camerong888/Capstone-PCB/Capstone PCB for gabe.png

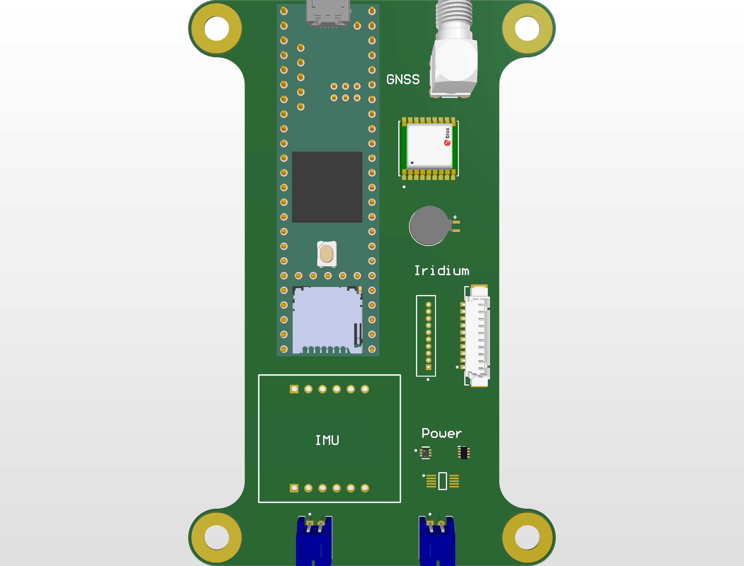
Capstone PCB for gabe.png
