camerong888/Capstone-PCB/Capstone PCB Top View.png

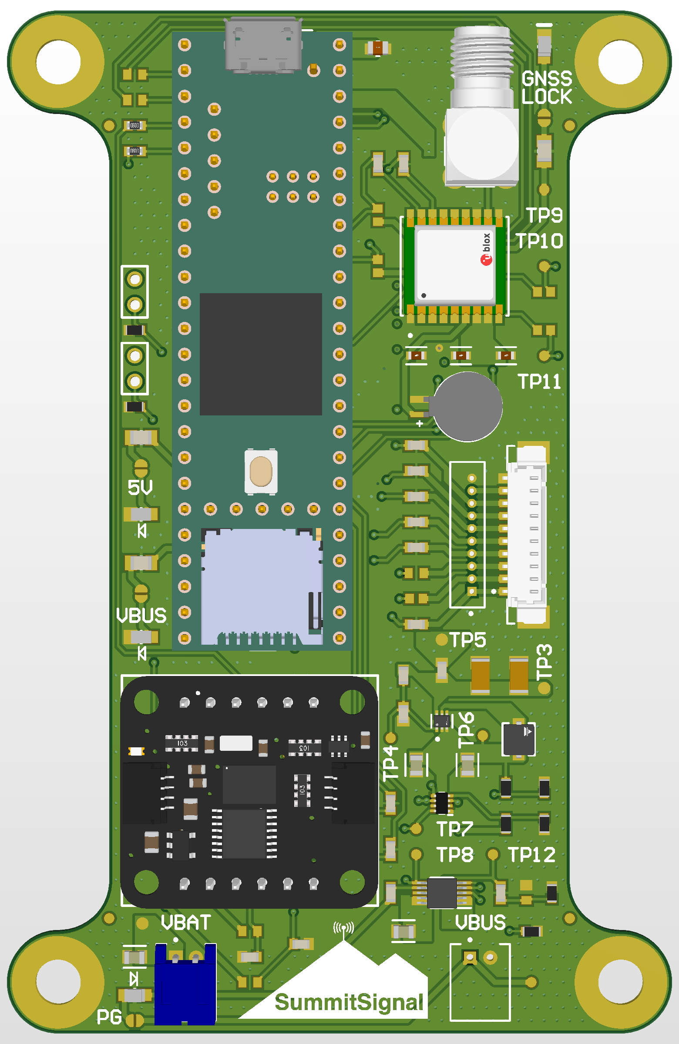
Capstone PCB Top View.png
