camerong888/Capstone-PCB/Capstone PCB back.png

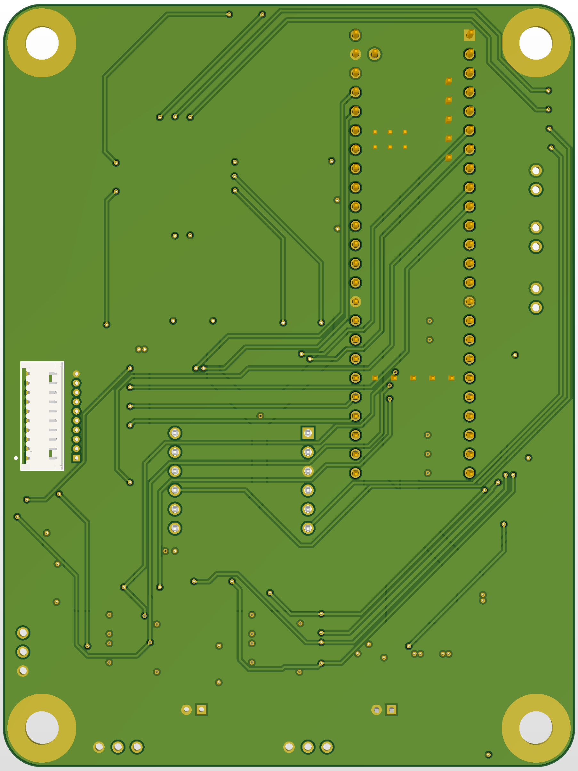
Capstone PCB back.png
