camerong888/Capstone-PCB/Capstone PCB Bottom View.png

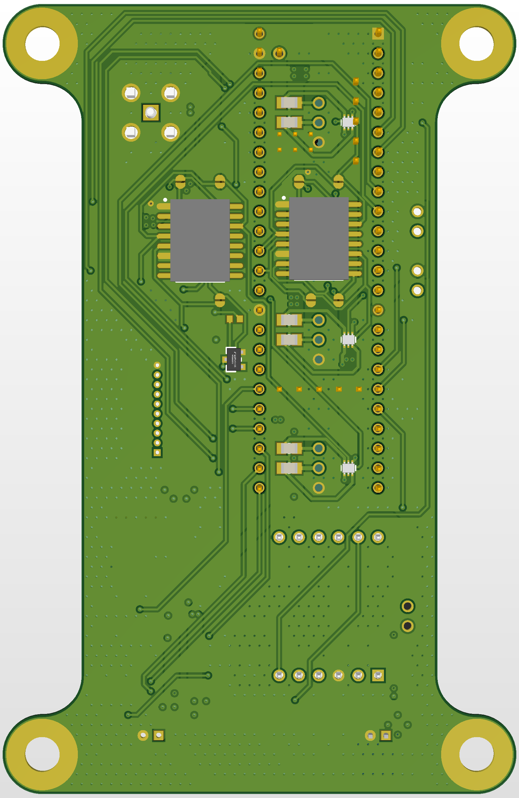
Capstone PCB Bottom View.png
