camerong888/Capstone-PCB/Capstone PCB Bottom.png

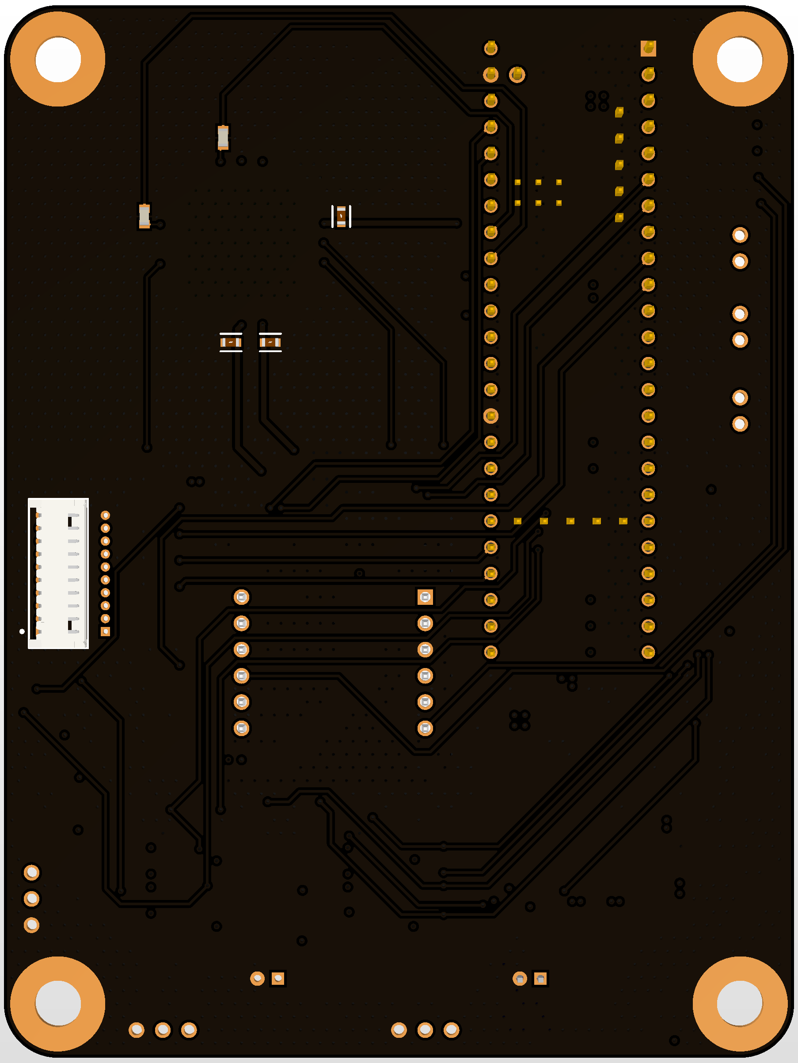
Capstone PCB Bottom.png
