camerong888/Capstone-PCB/Templates/Screen Shot 2023-08-04 at 3.56.56 PM.png

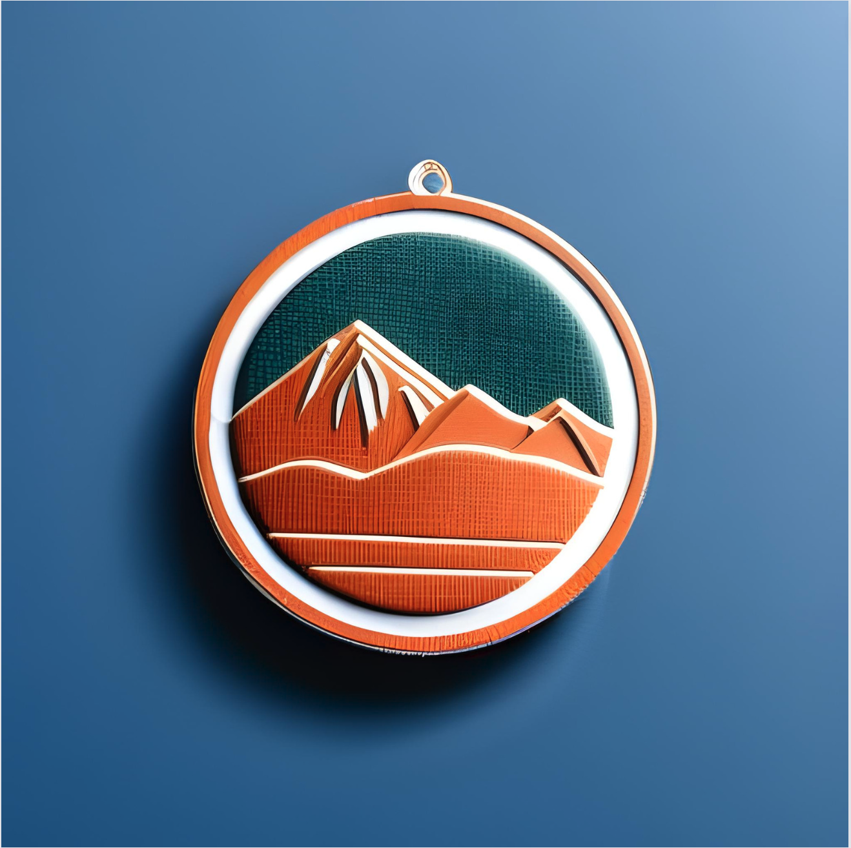
Templates/Screen Shot 2023-08-04 at 3.56.56 PM.png
