camerong888/Capstone-PCB/Templates/Screen Shot 2023-08-30 at 12.29.07 AM.png

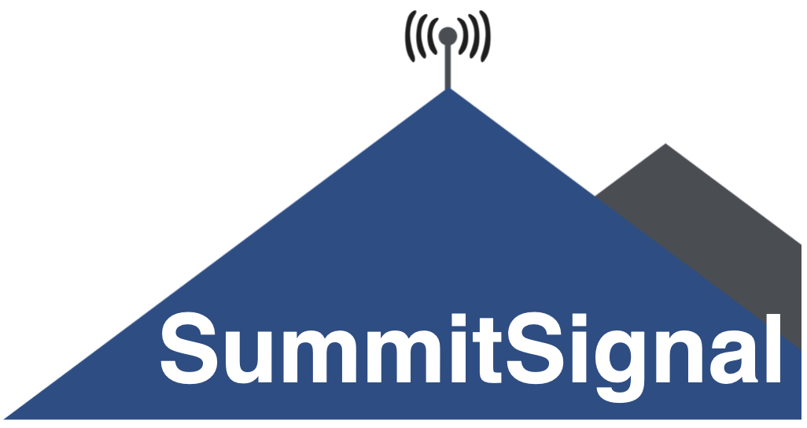
Templates/Screen Shot 2023-08-30 at 12.29.07 AM.png
