camerong888/Capstone-PCB/Templates/Slide Bottom - Light.png

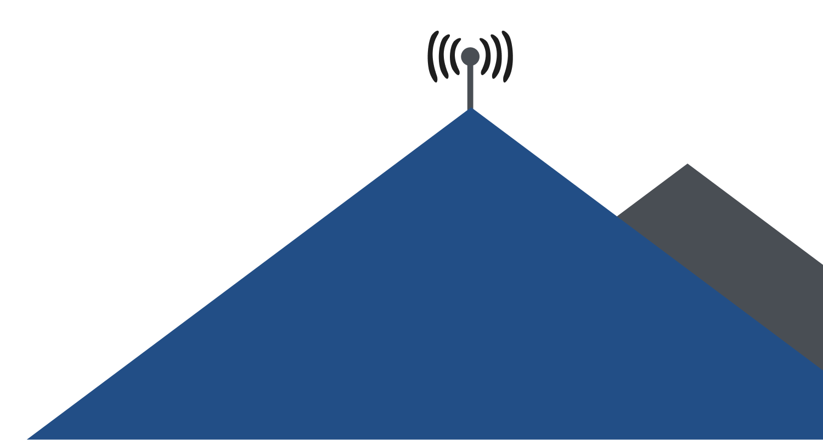
Templates/Slide Bottom - Light.png
