camerong888/Capstone-PCB/Capstone PCB with parts.png

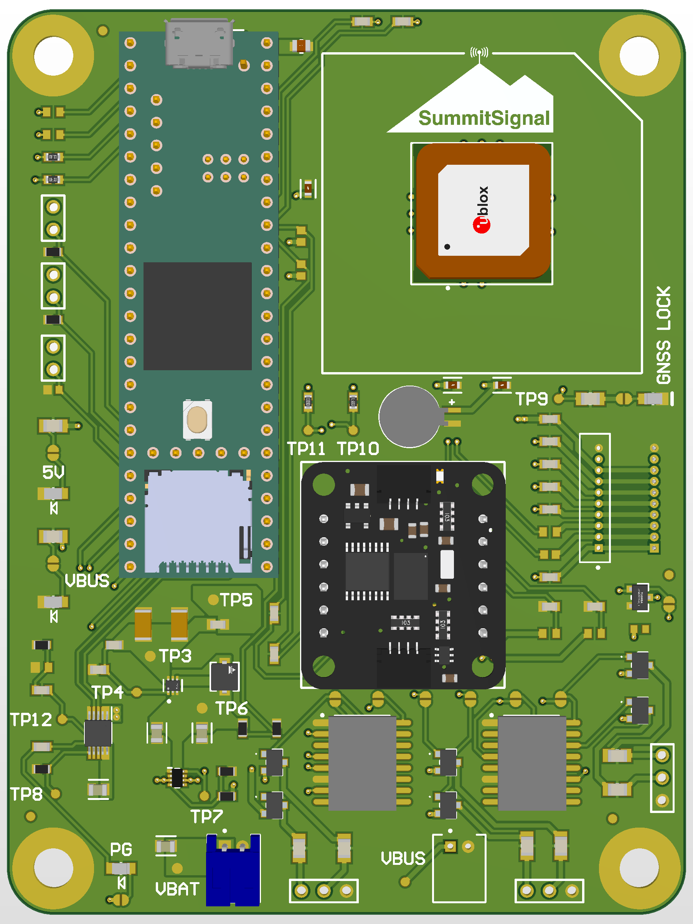
Capstone PCB with parts.png
