camerong888/Capstone-PCB/Capstone PCB.pdf

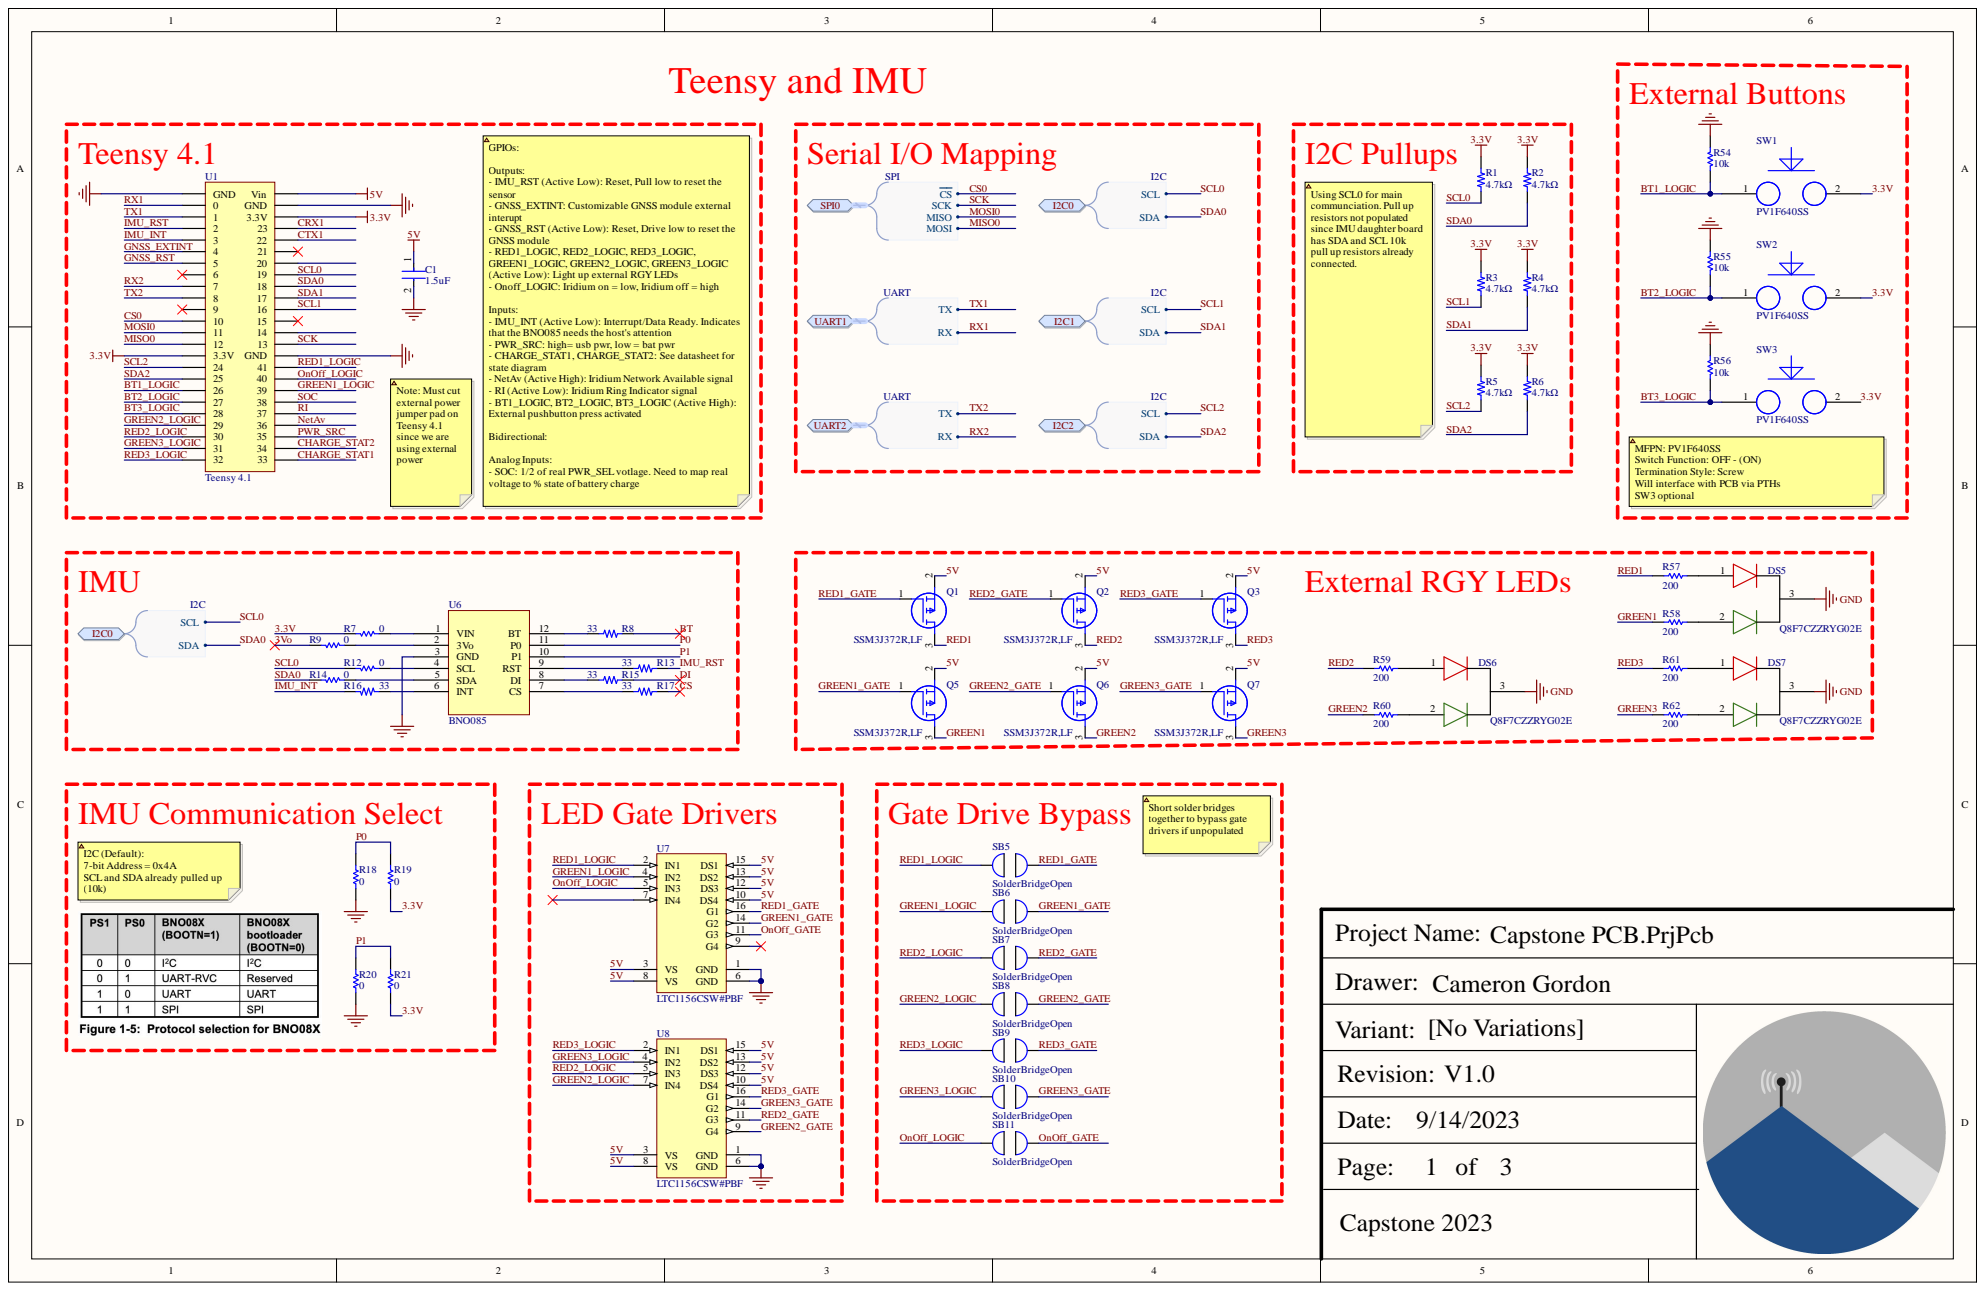
[picture p10: page 1]

Outputs:
- IMU_RST (Active Low): Reset, Pull low to reset the
sensor
- GNSS_EXTINT: Customizable GNSS module external
interupt
- GNSS_RST (Active Low): Reset, Drive low to reset the
GNSS module
- RED1_LOGIC, RED2_LOGIC, RED3_LOGIC,

Using SCL0 for main
communciation. Pull up
resistors not populated
since IMU daughter board
has SDA and SCL 10k
pull up resistors already
connected.

GREEN1_LOGIC, GREEN2_LOGIC, GREEN3_LOGIC
(Active Low): Light up external RGY LEDs
- Onoff_LOGIC: Iridium on = low, Iridium off = high

Inputs:
- IMU_INT (Active Low): Interrupt/Data Ready. Indicates
that the BNO085 needs the host's attention
- PWR_SRC: high= usb pwr, low = bat pwr
- CHARGE_STAT1, CHARGE_STAT2: See datasheet for
state diagram
- NetAv (Active High): Iridium Network Available signal
- RI (Active Low): Iridium Ring Indicator signal
- BT1_LOGIC, BT2_LOGIC, BT3_LOGIC (Active High):
External pushbutton press activated

MFPN: PV1F640SS
Switch Function: OFF - (ON)
Termination Style: Screw
Will interface with PCB via PTHs
SW3 optional

Analog Inputs:
- SOC: 1/2 of real PWR_SEL votlage. Need to map real
voltage to % state of battery charge

Shortsolder bridges
together to bypass gate
drivers if unpopulated

I2C(Default):
7-bit Address = 0x4A
SCL and SDA already pulled up

Project Name: Capstone PCB.PrjPcb

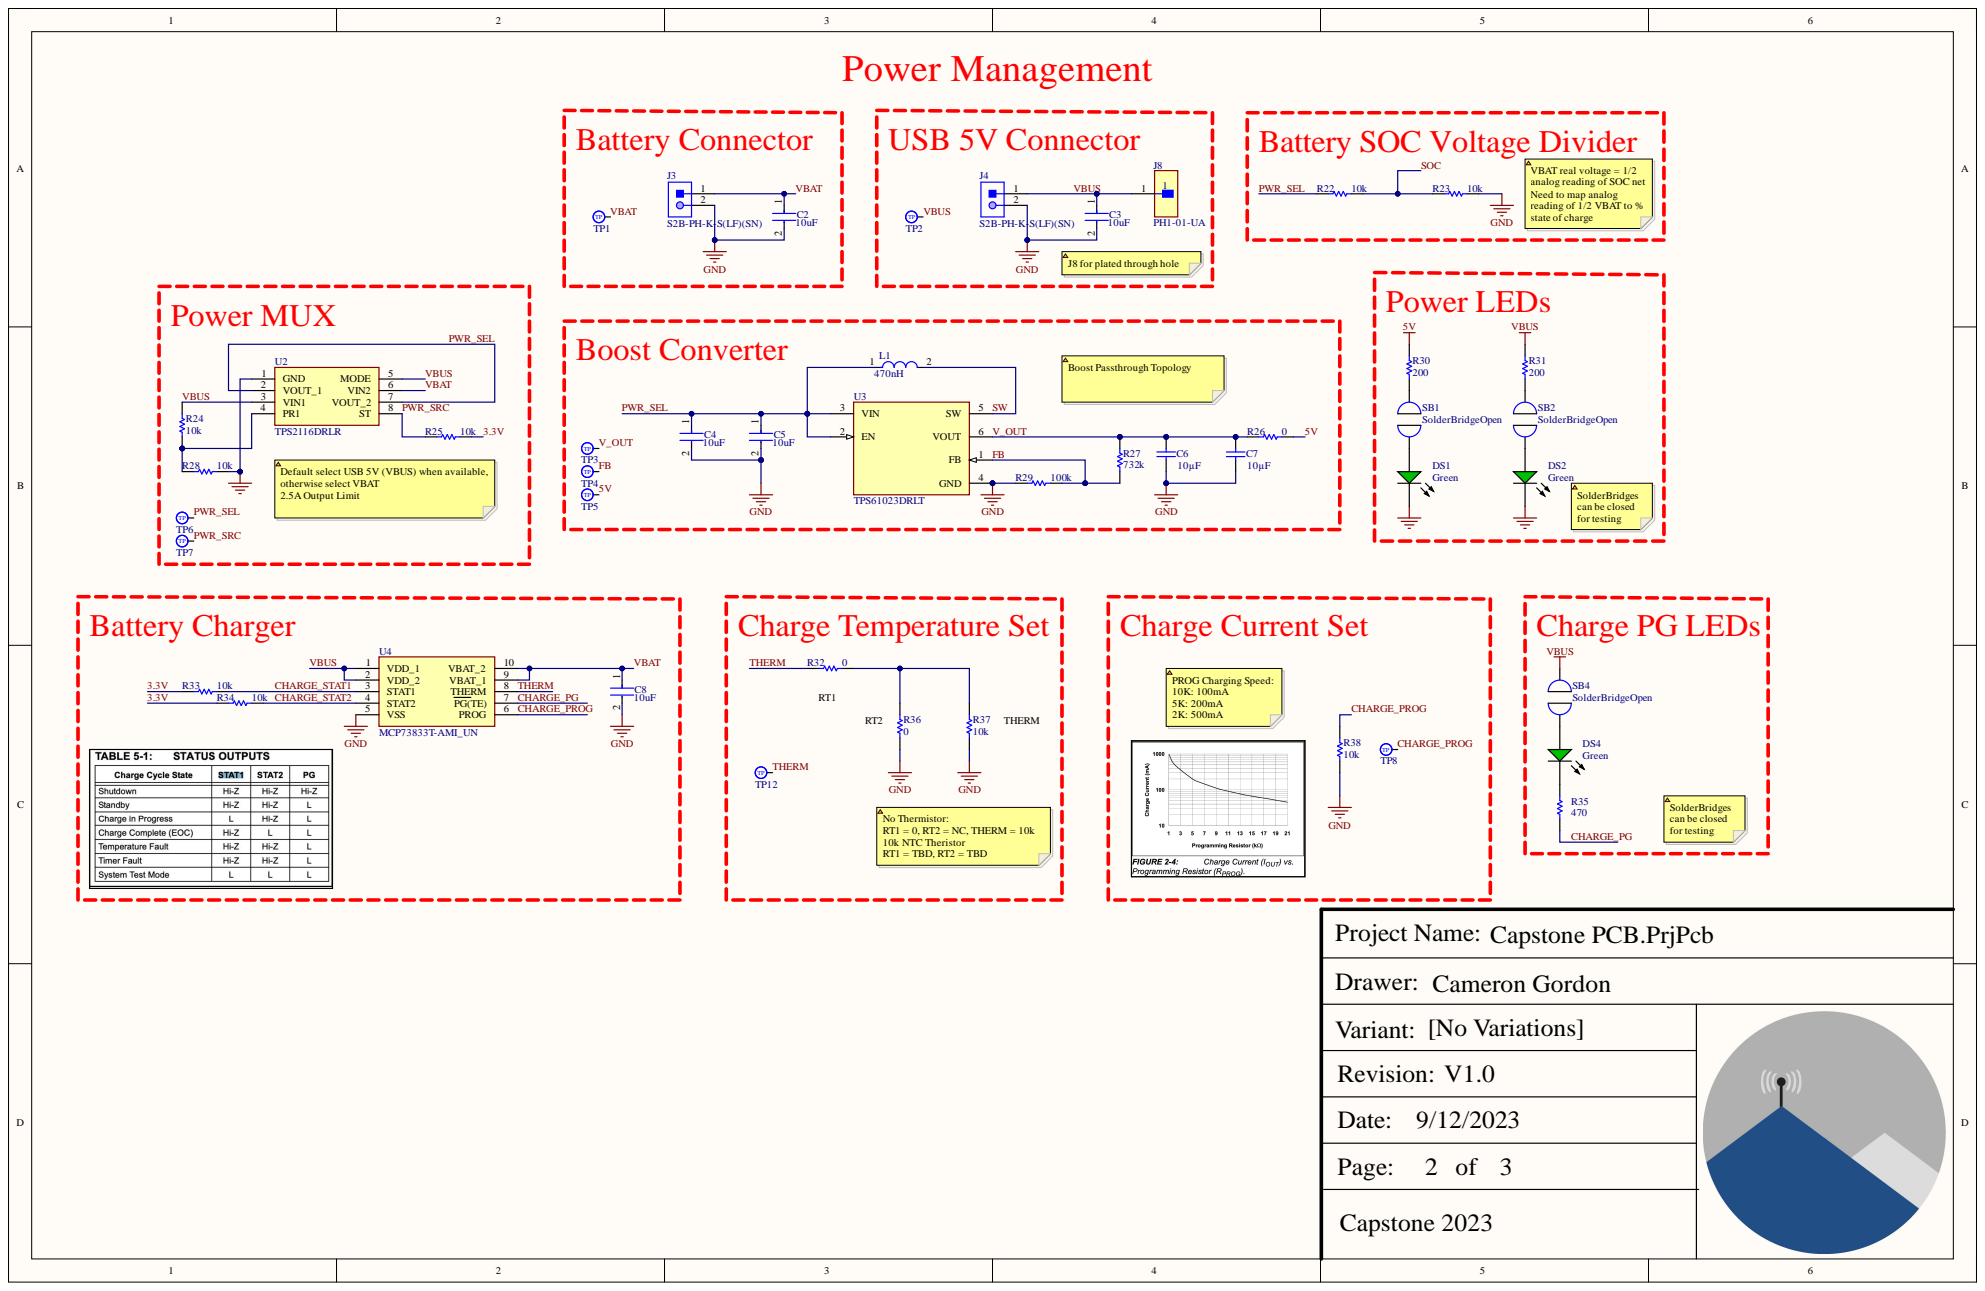
[picture p11: page 2]

Battery SOC Voltage Divider

VBAT real voltage = 1/2
analog reading of SOC net
Need to map analog
reading of 1/2 VBAT to %
state of charge

J8 for plated through hole

Default select USB 5V (VBUS) when available,
otherwise select VBAT
2.5A Output Limit

Project Name: Capstone PCB.PrjPcb

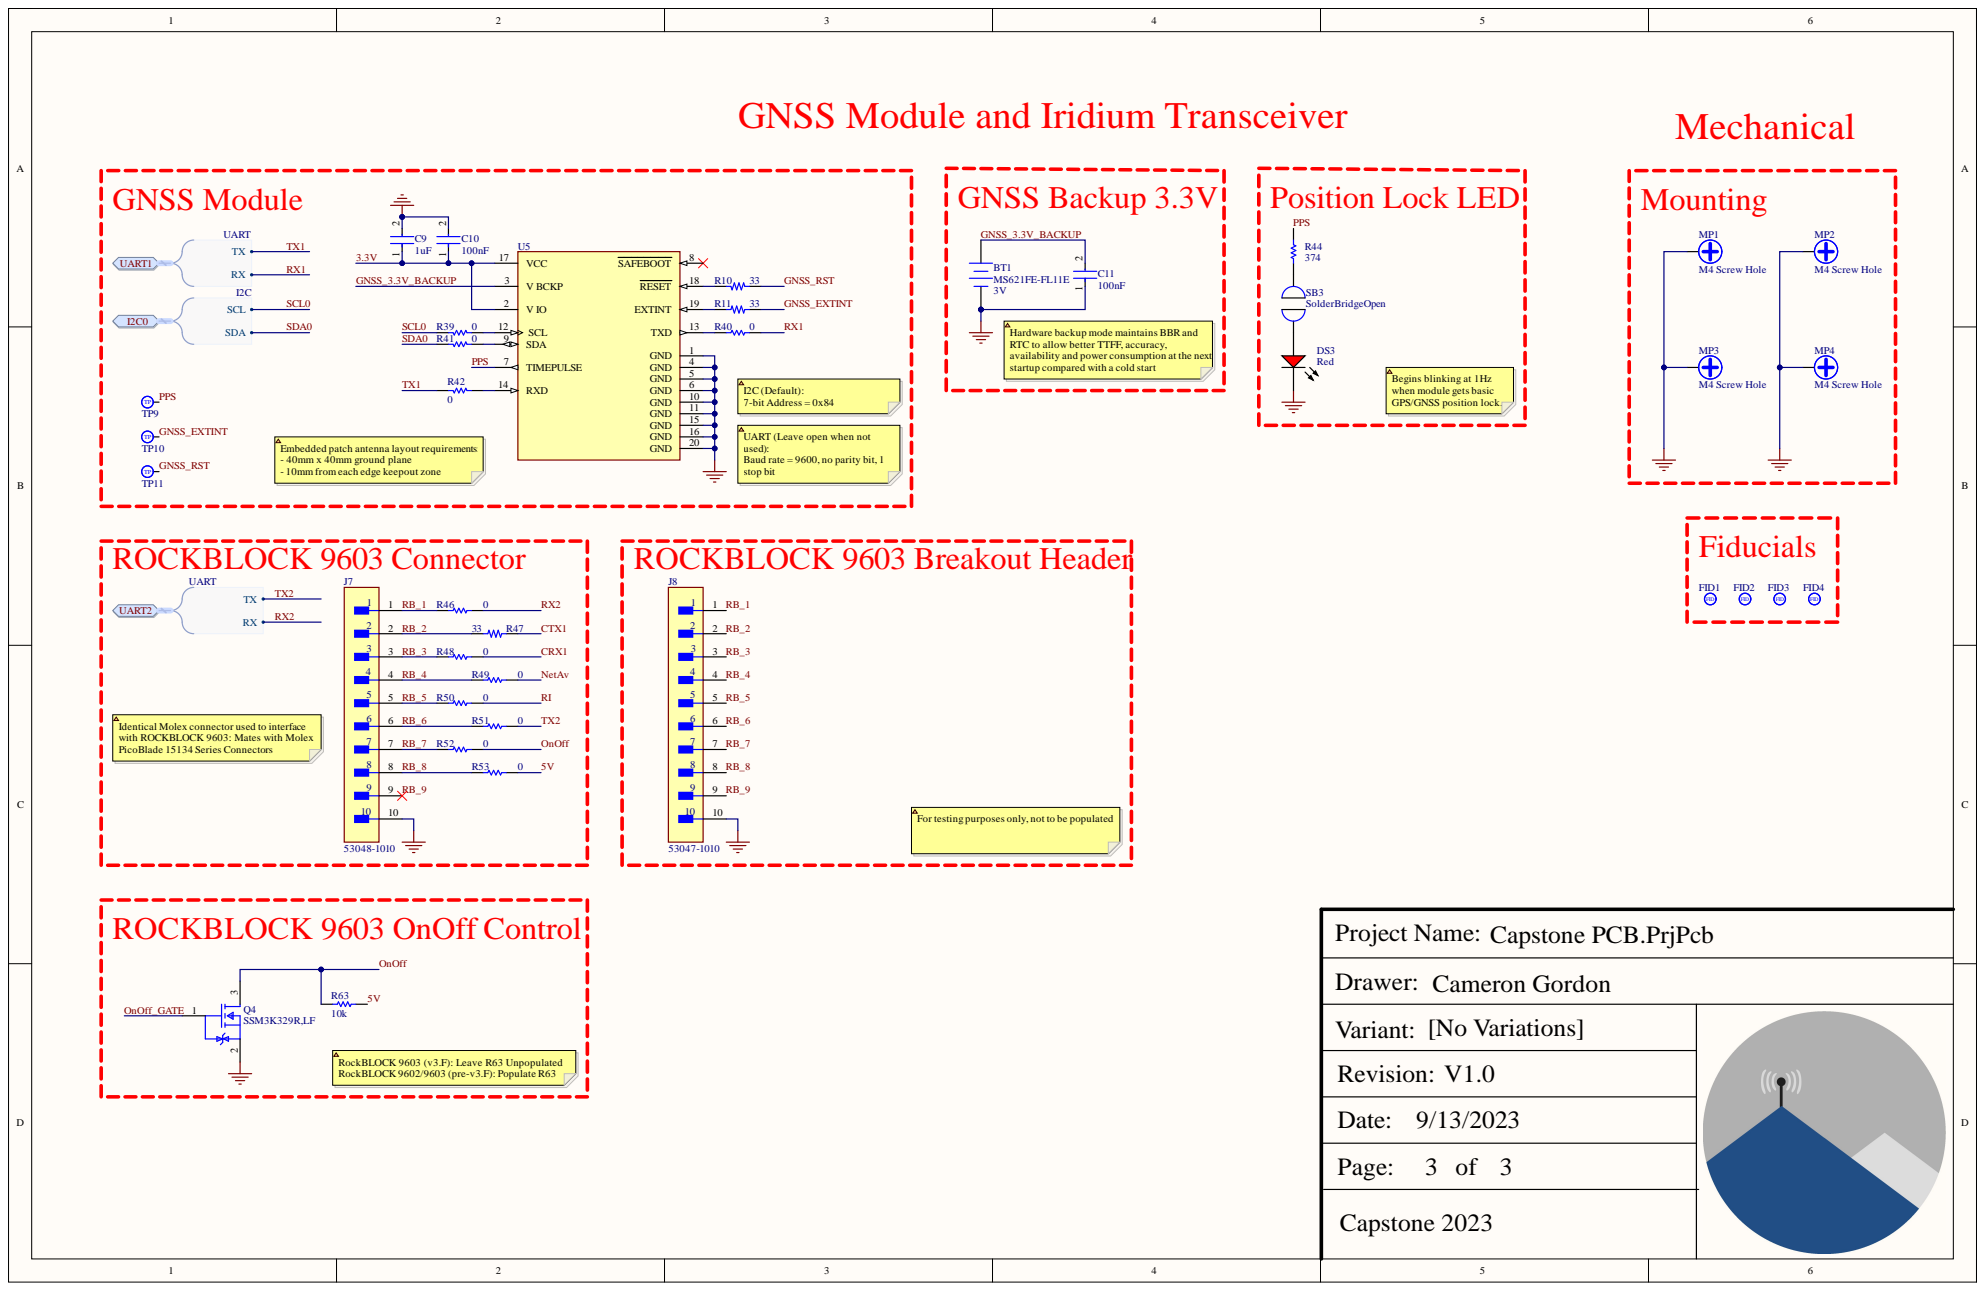
[picture p12: page 3]

ROCKBLOCK 9603 Breakout Header GNSS Module and Iridium Transceiver Red DS3 374 R44 SB3 SolderBri

Position Lock LED PPS

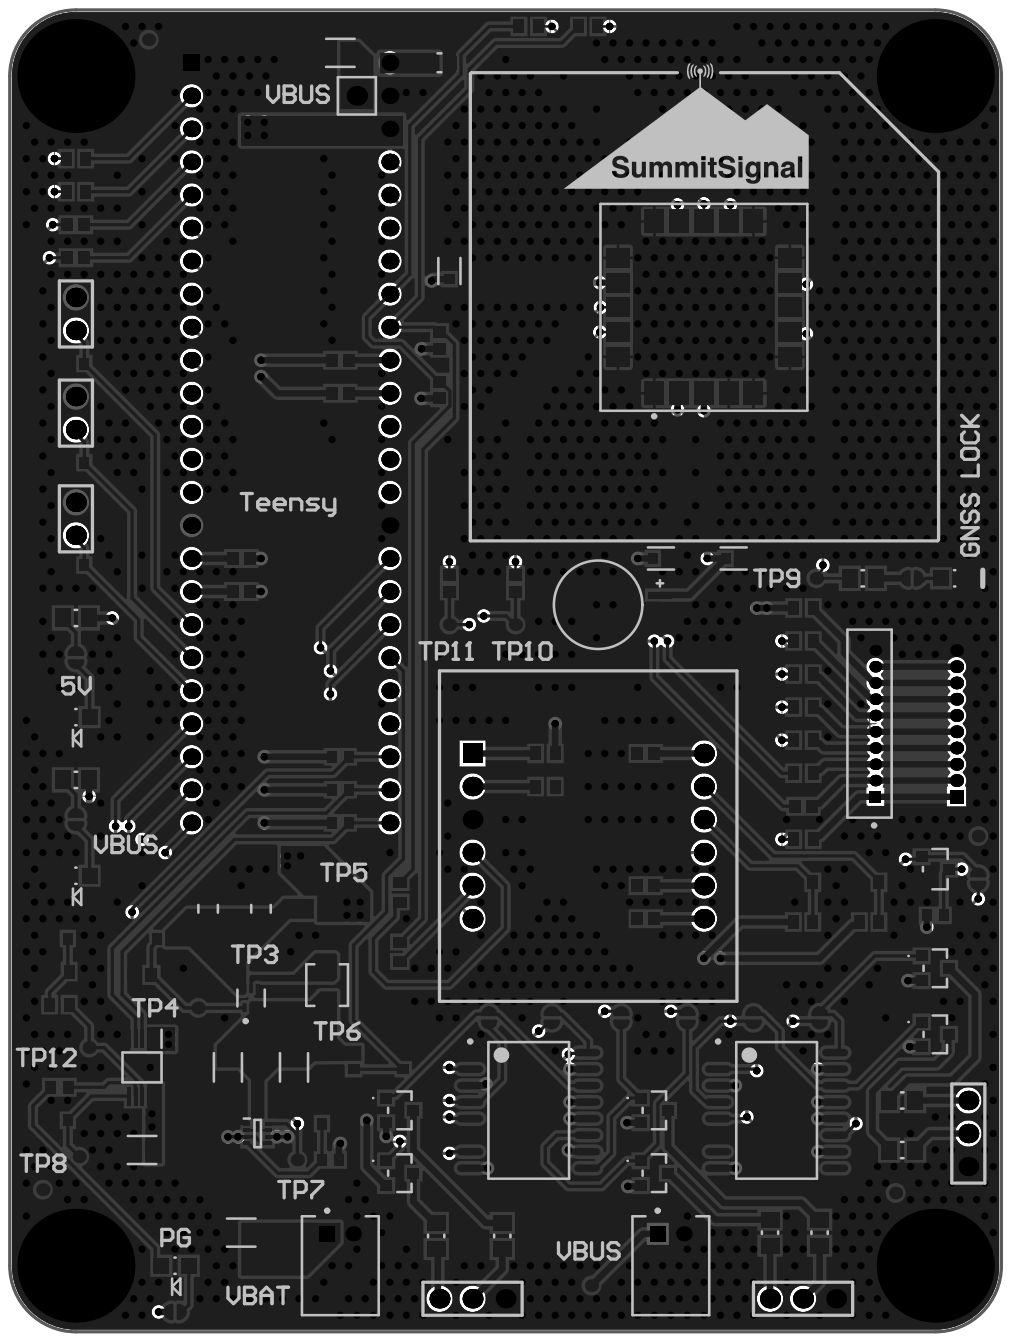
[picture p13: page 4]
