camerong888/Capstone-PCB/(list of files, drawings)

Other design files:
Capstone PCB.PcbDoc
Capstone PCB.PrjPcb
Communication.SchDoc
Power Management.SchDoc
Teensy and ICs.SchDoc
