camerong888/Capstone-PCB/(commit log)

2023-08-04 Updated Schematic Template
    [Capstone PCB.PrjPcb, Capstone PCB.SchDoc]
2023-08-04 Updated Template
    [Capstone PCB.SchDoc]
2023-08-04 Added charge stat note
    [Capstone PCB.SchDoc]
2023-08-04 Update Capstone PCB.SchDocPreview
2023-08-05 Added wire for demo
    [Capstone PCB.SchDoc]
2023-08-05 Create Capstone PCB.~(7).SchDoc.Zip
2023-08-05 real bridge demo
    [Capstone PCB.SchDoc]
2023-08-05 Added camerons's edit sch page
    [Cameron's Edits.SchDoc]
2023-08-05 Updated Cameron page
    [Cameron's Edits.SchDoc]
2023-08-07 Cameron Draft
    [Cameron's Edits.SchDoc, Capstone PCB.PrjPcb, Capstone PCB.SchDoc]
2023-08-07 added external button and led box
    [Cameron's Edits.SchDoc, Capstone PCB.SchDoc]
2023-08-09 Added 5V boost draft
    [Capstone PCB.PcbDoc, Capstone PCB.PrjPcb, Capstone PCB.SchDoc]
2023-08-09 boost converter
    [Capstone PCB.SchDoc]
2023-08-11 Updated boost circuit
    [Capstone PCB.SchDoc]
2023-08-13 Added Power Management Page
    [Cameron's Edits.SchDoc, Capstone PCB.PrjPcb, Capstone PCB.SchDoc, Power Management.SchDoc]
2023-08-13 Renamed Schematic Pages
    [Cameron's Edits.SchDoc, Capstone PCB.PrjPcb, GNSS Module.SchDoc, Teensy.SchDoc]
2023-08-13 Schematic Restructuring
    [Capstone PCB.PrjPcb, GNSS Module.SchDoc, Mechanical.SchDoc, Teensy.SchDoc]
2023-08-13 Project Restructure
    [Capstone PCB.PrjPcb, Communication.SchDoc]
2023-08-14 Finished Power Management Schematic Page
    [Communication.SchDoc, Mechanical.SchDoc, Power Management.SchDoc, Teensy and ICs.SchDoc]
2023-08-14 Added SolderBridge Library
    [Capstone PCB.PrjPcb, Communication.SchDoc]
2023-08-14 Updated Communication Schematic Page
    [Capstone PCB.PrjPcb, Communication.SchDoc, Power Management.SchDoc, Teensy and ICs.SchDoc]
2023-08-14 Added IMU
    [Teensy and ICs.SchDoc]
2023-08-14 Variant update
    [Capstone PCB.PrjPcb]
2023-08-14 Cleaned up schematics
    [Capstone PCB.PrjPcb, Communication.SchDoc, Mechanical.SchDoc, Power Management.SchDoc, Teensy and ICs.SchDoc]
2023-08-14 Updated Teensy GPIO note
    [Capstone PCB.PrjPcb, Power Management.SchDoc, Teensy and ICs.SchDoc]
2023-08-14 Removed note
    [Teensy and ICs.SchDoc]
2023-08-14 Updated teensy pinout
    [Teensy and ICs.SchDoc]
2023-08-14 Updated GPIO Table
    [Communication.SchDoc, Teensy and ICs.SchDoc]
2023-08-14 Annotated Schematic
    [Capstone PCB BOM.csv, Capstone PCB.PrjPcb, Communication.SchDoc, Power Management.SchDoc, Teensy and ICs.SchDoc]
2023-08-15 Added Logo
    [Communication.SchDoc, Power Management.SchDoc, Teensy and ICs.SchDoc]
2023-08-16 Added SOC analog input
    [Communication.SchDoc, Power Management.SchDoc, Teensy and ICs.SchDoc]
2023-08-18 Updated I2C pull up resistors and SOC resistors
    [Capstone PCB.PrjPcb, Power Management.SchDoc, Teensy and ICs.SchDoc]
2023-08-23 Initial layout
    [Capstone PCB.PcbDoc, Teensy and ICs.SchDoc]
2023-08-23 Updated 3d model
    [Capstone PCB.PcbDoc, Communication.SchDoc, Power Management.SchDoc]
2023-08-23 Updated board
    [Capstone PCB.PcbDoc]
2023-08-28 Updated 0402 components to 0805
    [Capstone PCB.PcbDoc, Capstone PCB.PrjPcb, Communication.SchDoc, Power Management.SchDoc, Teensy and ICs.SchDoc]
2023-08-30 Updated layer stack manager and impedance control rules
    [Capstone PCB.PcbDoc, Communication.SchDoc]
2023-08-30 Added ground pours
    [Capstone PCB.PcbDoc]
2023-08-30 JLCPCB design rules added
    [Capstone PCB.PcbDoc]
2023-08-30 Added Summit Signal Logo
    [Capstone PCB.PcbDoc, Capstone PCB.PrjPcb]
2023-08-30 Added VBUS connector
    [Capstone PCB.PcbDoc, Capstone PCB.PrjPcb, Power Management.SchDoc]
2023-08-30 Teensy GPIO Assignments
    [Capstone PCB.PcbDoc, Capstone PCB.PrjPcb, Communication.SchDoc, Power Management.SchDoc, Teensy and ICs.SchDoc]
2023-08-30 0805 to 0603
    [Capstone PCB.PcbDoc, Communication.SchDoc, Power Management.SchDoc, Teensy and ICs.SchDoc]
2023-08-30 Updated more 0805 to 0603 and begun layout
    [Capstone PCB.PcbDoc, Capstone PCB.PrjPcb, Power Management.SchDoc]
2023-09-05 Added IMU 3D body to PCB
    [Capstone PCB.PrjPcb, Communication.SchDoc, Power Management.SchDoc, Teensy and ICs.SchDoc]
2023-09-05 More updates
    [Communication.SchDoc, Power Management.SchDoc]
2023-09-06 Added RGY LEDs
    [Capstone PCB.PrjPcb, Communication.SchDoc, Power Management.SchDoc, Teensy and ICs.SchDoc]
2023-09-06 Placed LED components
    [Teensy and ICs.SchDoc]
2023-09-06 Updated LED GPIOs
    [Teensy and ICs.SchDoc]
2023-09-07 Power routing
2023-09-08 Updated ROCKBLOCK Pinout
    [Communication.SchDoc, Teensy and ICs.SchDoc]
2023-09-09 Added Gate Driver IC
    [Capstone PCB.PrjPcb, Communication.SchDoc, Mechanical.SchDoc, Teensy and ICs.SchDoc]
2023-09-09 Placed Components on backside of PCB
2023-09-10 Removed Notes
    [Communication.SchDoc, Power Management.SchDoc]
2023-09-10 Finished Routing Nets
    [Teensy and ICs.SchDoc]
2023-09-10 Cleared DRCs
    [Capstone PCB.PrjPcb, Communication.SchDoc, Teensy and ICs.SchDoc]
2023-09-12 GNSS OVERHAUL
    [Capstone PCB.PrjPcb, Communication.SchDoc]
2023-09-12 Cleaned up schematic
    [Communication.SchDoc, Power Management.SchDoc, Teensy and ICs.SchDoc]
2023-09-13 Updated RockBlock Connector
    [Capstone PCB.PrjPcb, Communication.SchDoc]
2023-09-13 Updated LED Fets for easier soldering
    [Teensy and ICs.SchDoc]
2023-09-14 Routing progress
    [Teensy and ICs.SchDoc]
2023-09-15 GNSS Decoupling caps on backside
    [Communication.SchDoc]
2023-09-16 Production Files
    [Capstone PCB.PrjPcb, Capstone PCB.csv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]
